bitovod/K197-ESP32S3/THIRD_PARTY_LICENSES.md

# Third-party licenses

**English** · [Česky](#licence-převzatých-částí)

The project itself is under the MIT license ([LICENSE](LICENSE)). These parts come from others and keep their own
licenses. The full texts are in [LICENSES/](LICENSES).

## Included in this repository (as generated data)

| Part | Where | Source | License |
|---|---|---|---|
| Antialiased fonts of the text screens | `firmware/ESP32S3_K197/font_data.h` (generated by `tools/gen_font.py`) | JetBrains Mono Bold, © 2020 The JetBrains Mono Project Authors; the dot inside the zero removed | SIL Open Font License 1.1, [LICENSES/JetBrainsMono-OFL-1.1.txt](LICENSES/JetBrainsMono-OFL-1.1.txt) |
| 5×7 pixel font of the graph | `firmware/ESP32S3_K197/font_pixel.h` (generated by `tools/gen_pixel_font.py`) | `glcdfont.c` of the Adafruit GFX Library, © 2012 Adafruit Industries; zero without the slash | BSD, [LICENSES/Adafruit-GFX-BSD.txt](LICENSES/Adafruit-GFX-BSD.txt) |
| "TAG" indicator | `firmware/ESP32S3_K197/tag_shape.h` (generated by `tools/gen_tag_shape.py`) | rendered from DejaVu Sans Condensed Bold | Bitstream Vera license / DejaVu changes public domain, [LICENSES/DejaVu-Bitstream-Vera.txt](LICENSES/DejaVu-Bitstream-Vera.txt) |
| Optional fonts of `tools/gen_font.py` | not included, only selectable | DejaVu Sans Mono, IBM Plex Mono, Red Hat Mono, Geist Mono | Bitstream Vera / SIL OFL 1.1 |

The font licenses allow embedding rendered glyphs in firmware. The font files themselves are not distributed
here.

The LCD artwork (`keithley_shapes.h`: digit segments, indicators, units) is the project author's own drawing of the
original K197 display and is covered by the project's MIT license.

## Libraries used when building (not included)

| Library | License |
|---|---|
| Arduino core for the ESP32 (Espressif), incl. Wire, SPI, EEPROM, FreeRTOS, ESP-IDF | LGPL-2.1 / Apache-2.0 (see the core) |
| Adafruit GFX Library, Adafruit BusIO | BSD |
| Vrekrer SCPI parser | MIT |

`libraries/DS3231Centisecond` and `libraries/Adafruit_NV3007` are by the project author and are covered by the MIT
license of this repository. `Adafruit_NV3007` is derived from the `Adafruit_SPITFT` class of the Adafruit GFX
Library (BSD, linked when building, not included). Despite its name it is not an Adafruit product. The register
values of its init sequence come from an ESP-IDF reference driver for the NV3007 panel.

## Trademarks

"Keithley" is a trademark of its owner. This project is not affiliated with Keithley Instruments or Tektronix. The
manufacturer name in the `*IDN?` reply is only there for compatibility with measurement software.

---

# Licence převzatých částí

Projekt samotný je pod licencí MIT ([LICENSE](LICENSE)). Následující části pocházejí od jiných autorů a mají vlastní
licence. Plná znění jsou ve složce [LICENSES/](LICENSES).

## Obsaženo v repozitáři (jako generovaná data)

| Část | Kde | Zdroj | Licence |
|---|---|---|---|
| Vyhlazené fonty textových obrazovek | `firmware/ESP32S3_K197/font_data.h` (generuje `tools/gen_font.py`) | JetBrains Mono Bold, © 2020 The JetBrains Mono Project Authors; odstraněná tečka v nule | SIL Open Font License 1.1 |
| Pixelový font 5×7 v grafu | `firmware/ESP32S3_K197/font_pixel.h` (generuje `tools/gen_pixel_font.py`) | `glcdfont.c` z Adafruit GFX Library, © 2012 Adafruit Industries; nula bez lomítka | BSD |
| Indikátor „TAG“ | `firmware/ESP32S3_K197/tag_shape.h` (generuje `tools/gen_tag_shape.py`) | vykresleno z DejaVu Sans Condensed Bold | licence Bitstream Vera / změny DejaVu volné dílo |
| Volitelné fonty `tools/gen_font.py` | nejsou přiloženy, jen volitelné | DejaVu Sans Mono, IBM Plex Mono, Red Hat Mono, Geist Mono | Bitstream Vera / SIL OFL 1.1 |

Licence fontů dovolují vložit vykreslené znaky do firmwaru. Samotné soubory fontů se zde nešíří.

Grafika LCD (`keithley_shapes.h`: segmenty číslic, indikátory, jednotky) je vlastní kresba autora projektu podle
původního displeje K197 a vztahuje se na ni licence MIT projektu.

## Knihovny potřebné k překladu (nejsou přiloženy)

| Knihovna | Licence |
|---|---|
| Arduino core pro ESP32 (Espressif), vč. Wire, SPI, EEPROM, FreeRTOS, ESP-IDF | LGPL-2.1 / Apache-2.0 (viz jádro) |
| Adafruit GFX Library, Adafruit BusIO | BSD |
| Vrekrer SCPI parser | MIT |

`libraries/DS3231Centisecond` a `libraries/Adafruit_NV3007` jsou od autora projektu a vztahuje se na ně licence MIT
tohoto repozitáře. `Adafruit_NV3007` je odvozená od třídy `Adafruit_SPITFT` z knihovny Adafruit GFX (BSD, připojuje
se při překladu, není přiložena). Navzdory názvu nejde o produkt firmy Adafruit. Hodnoty registrů v inicializační
sekvenci pocházejí z referenčního ovladače ESP-IDF pro panel s NV3007.

## Ochranné známky

„Keithley“ je ochranná známka svého vlastníka. Projekt nemá žádný vztah ke společnostem Keithley Instruments ani
Tektronix. Název výrobce v odpovědi `*IDN?` je tam jen kvůli kompatibilitě s měřicím softwarem.
