bitovod/K197-ESP32S3/docs/images/theme_grn.png

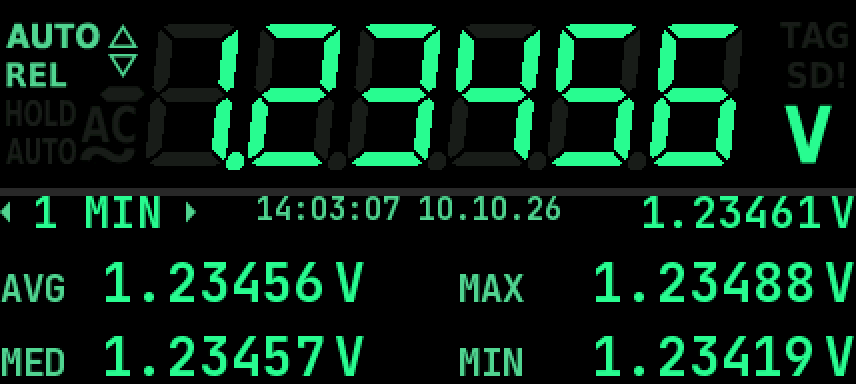
docs/images/theme_grn.png
