bitovod/K197-ESP32S3/docs/images/theme_lcd1.png

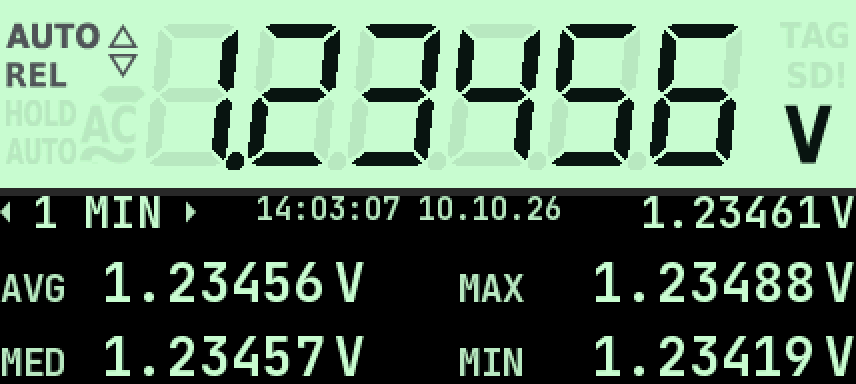
docs/images/theme_lcd1.png
