bitovod/K197-ESP32S3/docs/images/theme_red.png

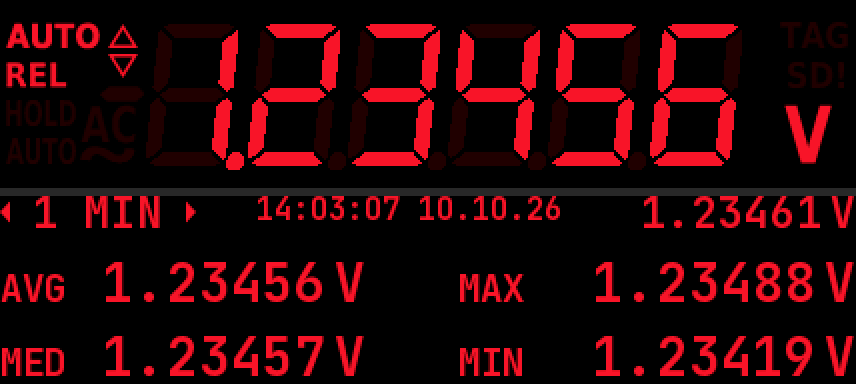
docs/images/theme_red.png
