bitovod/K197-ESP32S3/firmware/ESP32S3_K197/display.h

// display.h
// Public interface to the display handling in display.ino. Include
// this from any .ino file that needs to draw on the screen or read
// its current state - the pixel-level details stay in display.ino
// (and framebuffer.h).
//
// v7 changed HOW the screen gets drawn, not this API:
// every setter below now only records the requested state and wakes
// the render task (core 1) - it no longer touches the TFT. The render
// task composes a complete 428x94 frame into a 6bpp indexed
// framebuffer, and a low-priority blit task on core 0 streams the
// finished frame to the panel. Consequences worth knowing:
//   - the setters are cheap and never block, so the DMM capture task
//     (core 0, dmm_bridge.ino) calls them without any cost to its
//     timing, and they are safe to call from any task;
//   - what appears on the panel lags the call by the render settle
//     time plus one blit (a few ms to a few tens of ms), it is not
//     there yet when the call returns;
//   - the getters return the REQUESTED state, which is what the
//     panel will show a moment later.

#ifndef DISPLAY_H
#define DISPLAY_H

#include <Arduino.h>
#include "keithley_shapes.h"
#include "config.h"
#include <freertos/FreeRTOS.h>
#include <freertos/task.h> // TaskHandle_t (v16)

// RGB565(), struct KeithleyTheme and themes[]/themeCount live in
// config.h - that is the file to edit to add, remove or recolor a
// theme.
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
